Tekla-Avs/Electronic-Snake-Charming/(list of files, cad)

Other CAD files:
3D Models/15kgHelper.f3d
3D Models/Base.f3d
3D Models/HeadConnectorToServo.f3d
3D Models/MicroServoHelper.f3d
